AndrewMinWu/Clarinet-Hygrothermometer/README.md

# Clarinet Hygrothermometer







<table> <tr> <td>My Clarinets</td> <td>Functioning PCB</td> </tr> </table>

## Repository Structure

```text
├── hardware/          # Schematic, PCB, and gerber files
├── firmware/          # ESP-IDF C, using VSCode
└── docs/              # Datasheets
```

## Purpose & Motivation:
Having played the clarinet for over 8 years, I've grown to love my wooden instrument. However, in February of 2026, my instrument cracked due to a sudden drop in humidity (as my technician pointed out that wintertime brings dryer air). Thus, to prevent future issues and to save money from expensive repairs, I designed a PCB to accurately monitor the humidity and temperature within my clarinet case.

## Design

### Component List (BOM)
1. ESP32-C3-WROOM-02 ([Datasheet](https://www.espressif.com/sites/default/files/documentation/esp32-c3-wroom-02_datasheet_en.pdf))
2. MCP73831-2-OT Charge Controller ([Datasheet](https://ww1.microchip.com/downloads/en/DeviceDoc/20001984g.pdf))
3. AP2112K-3.3 LDO Voltage Regulator ([Datasheet](https://www.diodes.com/assets/Datasheets/AP2112.pdf))
4. GCT USB4105-GF-A USB-C Receptacle 16P SMD RA ([Datasheet](https://gct.co/files/drawings/usb4105.pdf))
5. SHT31 Humidity & Temperature Sensor ([Datasheet](https://sensirion.com/media/documents/213E6A3B/63A5A569/Datasheet_SHT3x_DIS.pdf))
6. OLED Display Breakout Board (4-pin I2C) ([Datasheet](https://cdn-shop.adafruit.com/datasheets/SSD1306.pdf))
7. 3.7V 1100mAh (4.1Wh) Lithium-Polymer Battery
8. SHT31 Breakout Board (4-pin I2C)
9. Passives & Miscellaneous Hardware:
   - Capacitors (0805, Ceramic)
   - Resistors (0805)
   - Charing Indicator LED
   - Push Buttons

### PCB, Schematic, Finished Board
The Schematic and PCB were designed in Altium. 



<table width="100%">
  <tr>
    <td width="50%"></td>
    <td width="50%">3D Render</td>
</table>

### Measurements

 I tested the accuracy of the SHT31 by putting the board in an enclosed tupperware container with a 49% Boveda humidity pack, and with a small vertical glass thermometer. I found the following:
* **Relative Humidity:** Accurate to ±2%.
* **Temperature:** Consistently reads ~0.8°C high. I believe this exceeds datasheet tolerances due to the sensor picking up some heat dissipated by the ESP32 (due to their proximity).

### Firmware
* **Language & Framework:** C / ESP-IDF, built in VSCode with PlatformIO (no external libraries)
* **I2C Configuration:** Bus at 100 kHz
* **Peripherals:** SHT31 temperature/humidity sensor and SSD1306 OLED
* **Display Driver:** Direct SSD1306 register setup with a 1024-byte static buffer
* **Font & Graphics:** Rendering using a custom 5x7 ASCII lookup table scaled 2x
* **Sampling & Control:** 2 Hz polling loop
## Assembly & Demonstration

**Short Demo**  
<video src="https://github.com/user-attachments/assets/3b9bc241-1b57-4820-86a4-abee198bdf83" width="100%" controls></video>

* **Assembly:** Hand-soldered all parts and tested the board with a multimeter (checking all voltage readings: VBAT, 3v3, 5V and ensuring no shorts) before flashing firmware.

## Active Development

* **Power Optimization:** Moving to deep-sleep mode to extend battery life beyond the current ~30-hour calculated runtime.
* **Data Logging:** Adding BLE (Bluetooth Low Energy) services to stream the SHT31 readings to my phone to monitor changes over time (i.e. how does the humidity change depending on the season?).

<div align="center">
  <p><strong>My messy home workbench</strong></p>
  Workbench
</div>
