AndrewMinWu/Clarinet-Hygrothermometer/(list of files, drawings)

Other design files:
Hardware/ClarinetSensor.PcbDoc
Hardware/ClarinetSensor.PrjPcb
Hardware/ClarinetSensor.SchDoc
Hardware/ClarinetSensor.SchLib
