AndrewMinWu/Clarinet-Hygrothermometer/(commit log)

2026-09-19 Reorganized file structure
    [ClarinetSensor-B_Cu.gbl, ClarinetSensor-B_Mask.gbs, ClarinetSensor-B_Paste.gbp, ClarinetSensor-B_Silkscreen.gbo, ClarinetSensor-Edge_Cuts.gm1, ClarinetSensor-F_Cu.gtl, ClarinetSensor-F_Mask.gts, ClarinetSensor-F_Paste.gtp]
2026-09-20 Changed the polling rate
    [ClarinetSensor.kicad_sch]
2026-09-20 Simplify assembly description in README
2026-09-20 Update section title for PCB and Schematic
2026-09-21 Updated Readme
    Updated the design tool information for the schematic and PCB.
2026-09-28 Updated firmware
    [ClarinetSensor.PcbDoc, ClarinetSensor.PrjPcb, ClarinetSensor.SchDoc, ClarinetSensor.SchLib]
2026-09-28 Organized files properly (hardware)
    [ClarinetSensor-B_Cu.gbl, ClarinetSensor-B_Mask.gbs, ClarinetSensor-B_Paste.gbp, ClarinetSensor-B_Silkscreen.gbo, ClarinetSensor-Edge_Cuts.gm1, ClarinetSensor-F_Cu.gtl, ClarinetSensor-F_Mask.gts, ClarinetSensor-F_Paste.gtp]
